KoshAlmaron/A650E_Transmission_Controller/docs/АКПП в разрезе.png

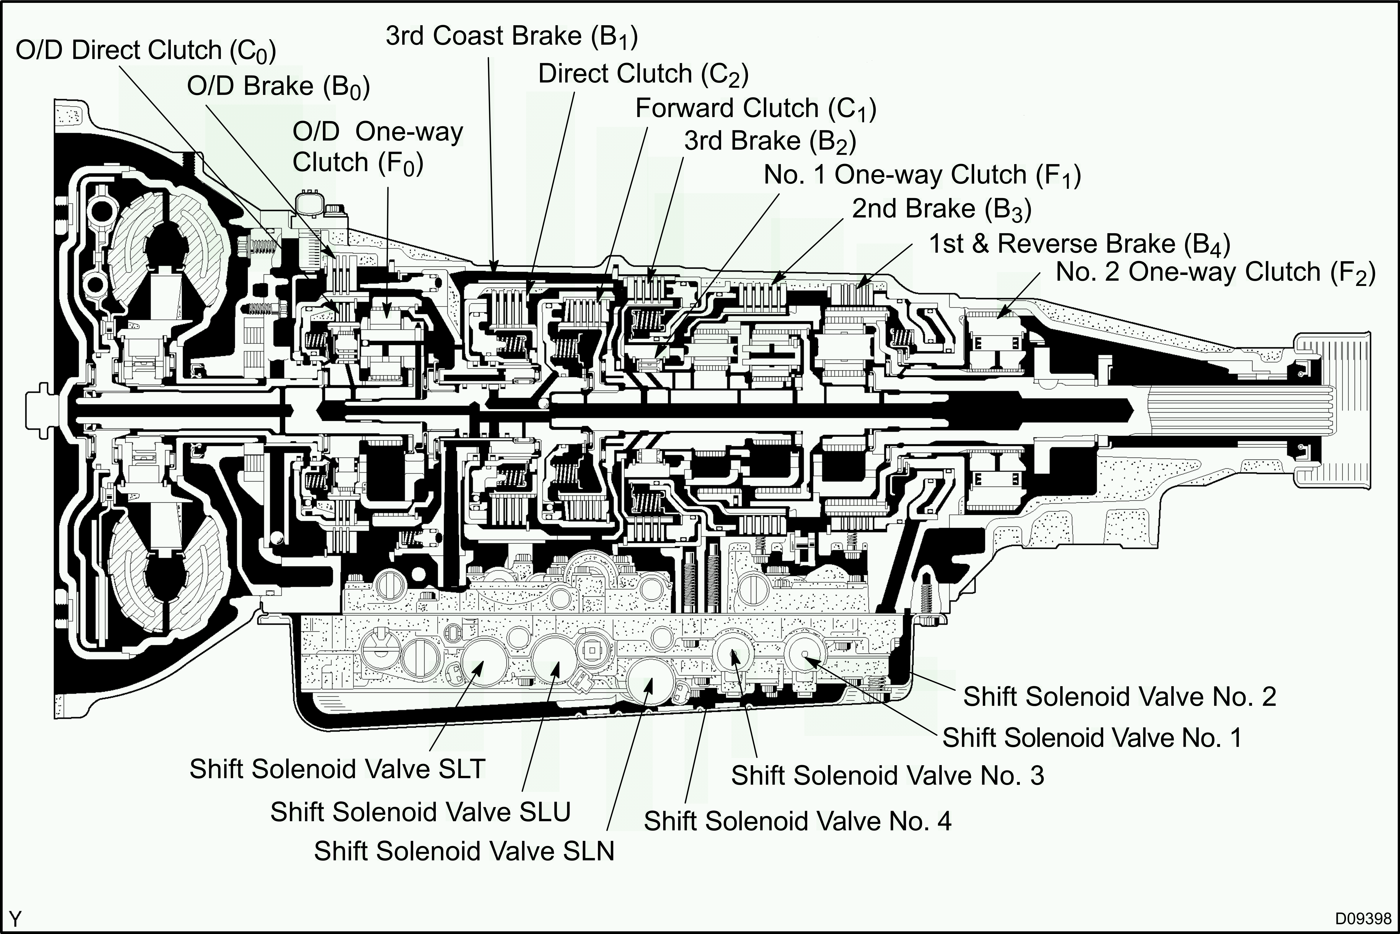
docs/АКПП в разрезе.png
