KoshAlmaron/A650E_Transmission_Controller/docs/Магия второй передачи №1.jpg

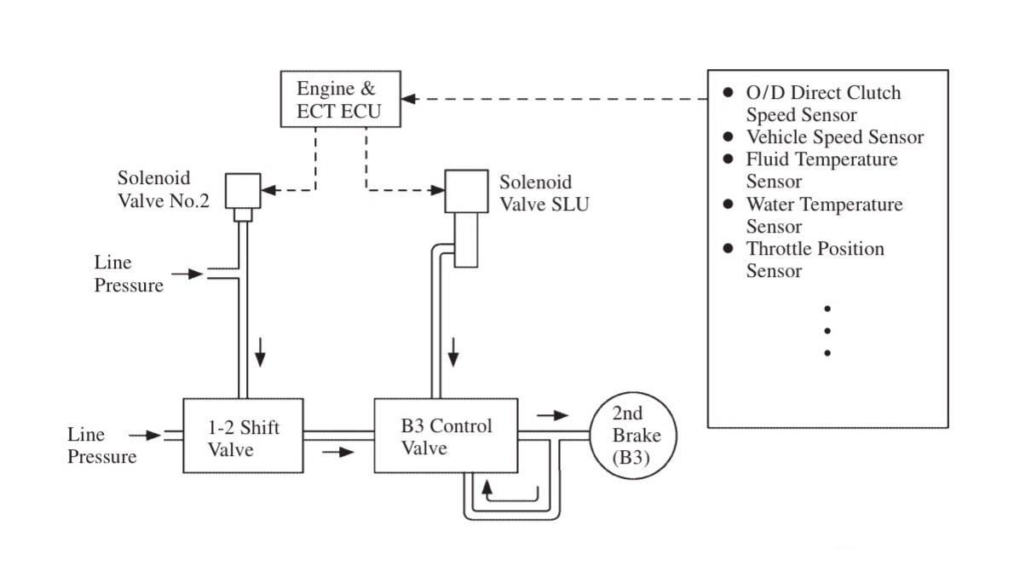
docs/Магия второй передачи №1.jpg
