KoshAlmaron/A650E_Transmission_Controller/docs/Преобразователь сигнала индуктивного датчика.png

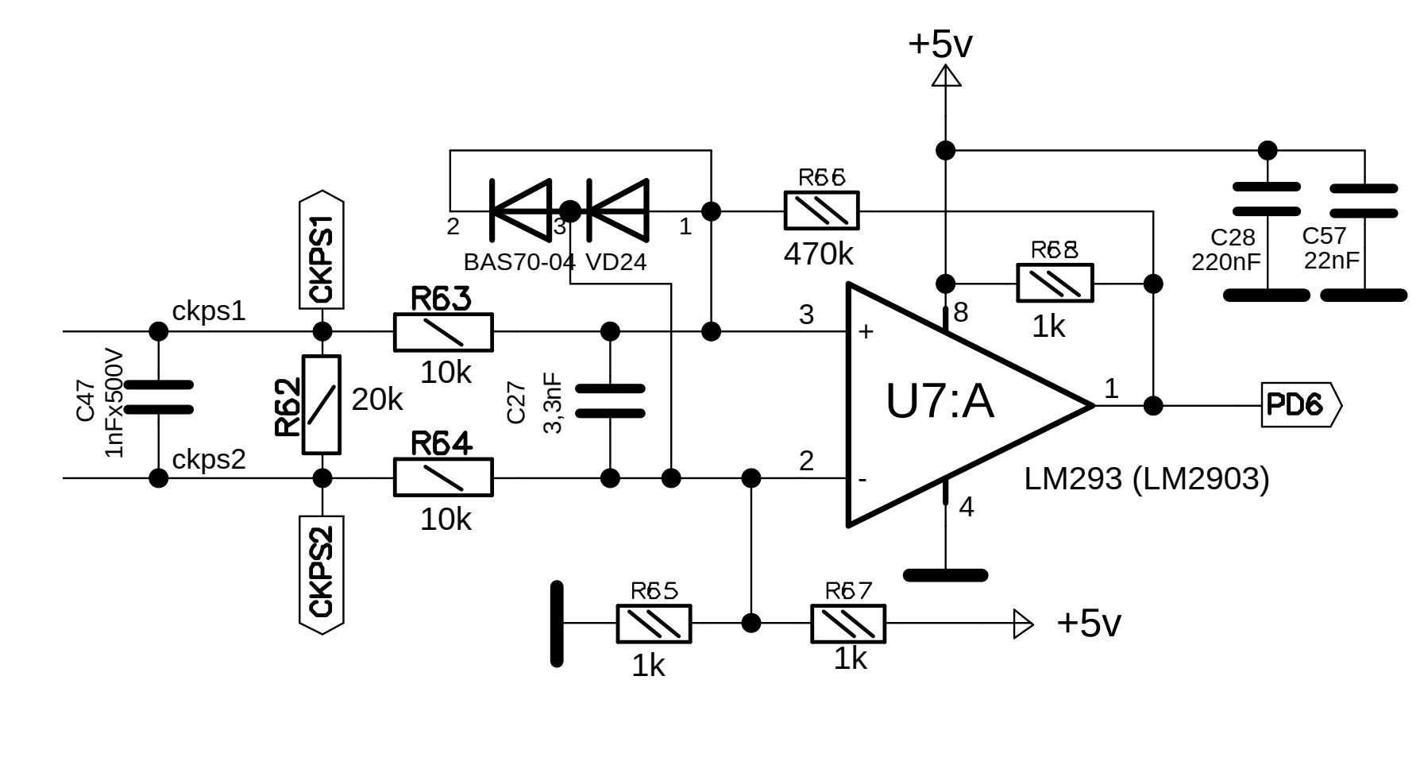
docs/Преобразователь сигнала индуктивного датчика.png
