KoshAlmaron/A650E_Transmission_Controller/docs/Таблица включения соленойдов v2.png

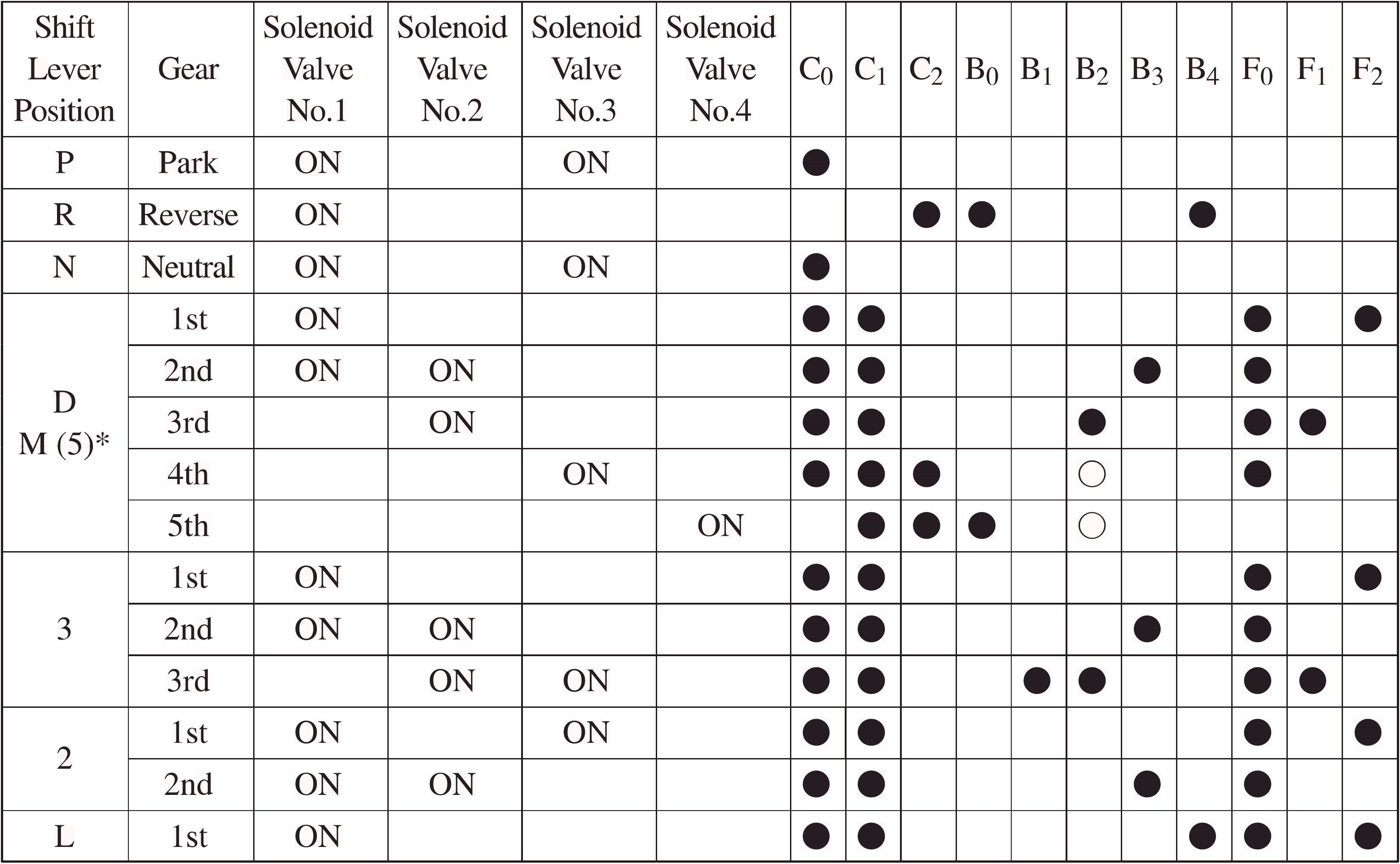
docs/Таблица включения соленойдов v2.png
