KoshAlmaron/A650E_Transmission_Controller/CHANGELOG.md

2024-02-27 - Старт проекта.
2024-03-02 - Написал код для датчиков скорости и температуры.
				Откалибровал датчик температуры.
2024-04-24 - Переход с Ардуино-костыля "Wiring" на номальный AVR C.
2024-05-27 - Написана общая логика работы ЭБУ.
2024-06-13 - Написан весь необходимый функционал для работы АКПП.
2024-06-14 - Добавил функцию обнаружения проскальзывания.
2024-06-20 - Исправил ошибку положения селектора.
				Включил аппаратный фильтр входного сигнала для датчиков оборотов.
2024-07-02 - Добавил управление лампой заднего хода.
2024-07-25 - Добавил управление соленоидами торможения двигателем
				при переключении режимов на ходу.
2024-08-15 - Добавил замедление уменьшения значения ДПДЗ.
				Добавил управление блокировкой гидротрансформатора.
2024-08-20 - Добавил график времени переключения от ДПДЗ.
2024-08-23 - Изменил алгоритм расчета и фильтрации значений датчиков оборотов.
2024-08-31 - Много исправлений алгоритмов переключения передач после первого теста на АКПП.
2024-09-01 - Добавил два отдельных графика от ДПДЗ: 
					время на переключение передачи и задержка после переключения.
				Переделал алгоритм переключений 1>2, 2>3, 3>2.
2024-09-02 - Добавил два графика для включения второй передачи:
				Начальное давление тормоза B3 от ДПДЗ и коррекция от температуры масла.
2024-09-04 - Переписал алгоритм переключений 1>2, 2>3, 3>2.
				Добавил возможность настраивать и сохранять в EEPROM параметры с
				помощью блока отладки.
2024-09-05 - Настроил график давления SLU для включения второй передачи.
2024-09-06 - Добавил экран настройки температурной коррекции SLU для B3.
				Уменьшил шаг сетки графиков по ДПДЗ и температуре масла с 10 до 5.
				Добавил график давления SLT для включения третьей передачи.
2024-09-07 - Еще раз переделал алгоритм переключения передач.
2024-09-08 - Добавил включение соленоида S3 при переключениях 1>2, 2>3, 3>2.
				Сделал плавное включение и выключение блокировки гидротрансформатора.
2024-09-10 - Исправил температурную коррекцию давления, добавка должна быть в процентах.
2024-09-13 - Добавил торможение двинателем на второй передаче в режимах "2" и "3".
				Добавил переключения по оборотам при дросселе более указанного значения.
2024-09-15 - Исправил работу соленоида S3 в режиме "3", исправил включение второй передачи
				после ХХ.
2024-09-26 - Уменьшил тайминги переключения передач.
2024-09-30 - Добавил график давления SLN и график дельты оборотов для включения
				второй передачи после ХХ.
2024-10-08 - Изменил алгоритм управления второй передачей.
2024-10-28 - Управление включением второй передачи происходит не по давлению SLU/SLT,
				а по задержке выключения давления SLU.
2024-10-29 - Исправил зависание заднего хода при резком переключении N->R->D.
2024-11-26 - Добавил дельту оборотов включения второй передачи после ХХ в настройки.
				Улучшил функцию блокировки гидротрансформатора.
2024-11-30 - Исправил ошибку в новой функции блокировки гидротрансформатора.
2024-12-13 - Изменил алгоритм управления SLN.
				Сделал вывод параметров EEPROM в UART при сохранении.
2024-12-14 - Исправил ошибку в работе функции slu_gear2_control.
2025-01-06 - Изменил алгоритм переключения 1>2, 2>3.
				Добавил ограничение включения 5-ой передачи при температуре < 30.
2025-01-11 - Откатил назад алгоритм переключения 1>2.
				Изменил переключение 2>3.
2025-01-13 - Применил температурную коррекцию к значению накачки SLU.
2025-01-20 - Изменил условия срабатывания накачки давления SLU.
2025-02-06 - Изменил расчет прироста SLU при включении второй передачи.
2025-02-12 - Немного изменил работу накачки давления SLU.
2025-04-11 - Добавил функцию запроса снижения мощности вместе
				с контролем включения передачи по оборотам валов.
2025-04-14 - Изменил алгоритм включения второй передачи.
2025-04-07 - Изменил алгоритмы переключений 1>2, 2>3.
2025-04-18 - Добавил функцию автокоррекции давления SLU включения второй передачи.
2025-04-21 - Добавил включение первой передачи через четвертую (N>D), а также
				включение четвертой передачи стоя на месте в режиме D.
2025-04-22 - Изменил алгоритм реакцивации второй передачи.
2025-04-24 - Изменил алгоритм переключения 2>3.
2025-05-03 - Убрал включение четвертой (третьей) вместо первой (2025-04-21), 
				так как это добавляет больше проблем, чем пользы.
2025-05-05 - Изменил алгоритм переключения 2>3.
2025-05-14 - Изменил алгоритм работы блокировки ГТ.
2025-05-16 - Навёл порядок в коде блока отладки.
2025-05-20 - Перешёл на 10-ти битный ШИМ для соленоидов.
2025-05-21 - Исправил работу второй передачи в режимах "3" и "2".
2025-05-27 - Изменил работу блокировки ГТ при переключении передач.
2025-06-10 - Добавил коррекцию по температуре включения SLN при переключении 2>3.
2025-07-21 - Исправил алгоритм реактивации второй передачи.
				Увеличил точность вычисления температурной коррекции.
2025-07-22 - Исправил свежедобавленный баг в функции интерполяции.
2025-07-28 - Мелкие исправления в работе второй передачи.
2025-07-29 - Добавил возможность выбора пинов селектора.
2025-08-06 - Добавил возможность инверсии ШИМ соленоидов в настройках.
2025-08-07 - Добавил возможность инверсии входов в настройках.
				Вернул назад выход на спидометр.
2025-09-05 - Добавил протокол обмена по UART: приём/передача таблиц, запись в EEPROM.
2025-09-08 - Добавил опцию определения работы двигателя по сигналу тахометра.
				Небольшие исправления в протоколе обмена и в алгоритме второй передачи.
2025-09-11 - Добавил в протокол обмена команду чтения из EEPROM.
				Добавил второй порог определения работы двигателя по сигналу тахометра.
2025-09-12 - Добавил второй выход на спидометр и команду тестирования спидометра.
				Добавил в протокол обмена команду установки ограничения передач.
2025-09-16 - Добавил в протокол обмена команду сброса таблиц на значения из прошивки.
				Добавил в пакет данных обороты двигателя.
2025-09-18 - Добавил задержку сброса флага работы двигателя.
2025-10-01 - Исправил ошибку применения адаптации по температуре для второй передачи.
2025-10-02 - Мелкие исправления в работе второй передачи.
2025-10-07 - Добавил в протокол обмена команды применения адаптации второй передачи.
				Добавил график коррекции времени удержания SLU G3 от температуры.
2025-10-09 - Добавил авто адаптацию времени удержания SLU при включении третьей передачи.
2025-10-13 - Изменил алгоритм включения второй передачи.
				Добавил авто адаптацию повторного включения второй передачи.
2025-10-27 - Изменил алгоритм включения режимов RND.
2025-10-31 - Перенес графики АЦП в EEPROM.
2025-11-01 - Изменил диапазон таблиц с процентами: SLTTempCorrGraph, SLUGear2TempCorrGraph,
				SLUGear2TempAdaptGraph. Теперь 100% это 1024, было 100.
				Сделал применение адаптации к двум ячейкам, между которыми находится рабочая точка,
				адаптация между точками распределяется на основе близости к рабочей точке.
2025-11-10 - Исправил ошибку в работе алгоритма адаптации повторного включения второй передачи.
2025-11-15 - Исправил ошибку в выводе ШИМ сигнала для спидометра.
2025-11-21 - Перенес все настройки в EEPROM.
2025-11-27 - Добавил две таблицы: Температурная коррекция опережения по оборотам реактивации
				второй передачи и Адаптация коррекции опережения по оборотам реактивации второй передачи.
				При выключении питания сохраняются в EEPROM только таблицы адаптации.
				Обновил протокол обмена.
				Исправление мелких ошибок в коде.
2025-11-30 - Исправил ошибки предыдущего обновления.
2025-12-01 - Новый алгоритм распределения адаптации между соседними ячейками.
2025-12-08 - Добавил таблицу температурной коррекции для SLN.
2025-12-09 - Перенес все таблицы в структуры.
				Добавил флаги срабатывания адаптаций в основной пакет.
2025-12-14 - Добавил контрольную сумму в протоколе обмена.
				Исправил ошибку при записи EEPROM.
2025-12-16 - Добавил автоматическое переключение между UART0 и UART1.
2025-12-30 - Добавил ручное управление АКПП (Типтроник).
2026-01-09 - Добавил барокоррецию. Исправил ошибки в работе типтроника.
2026-01-20 - Добавил новые функции кнопок ручного управления АКПП (Типтроник).
2026-01-26 - Убрал проверку оборотов для переключения при смене режима АКПП селектором.
2026-02-11 - Добавил команду отправки версии прошивки.
2026-02-12 - Добавил одометер. Изменил формулу расчета скорости.
2026-03-20 - Исправил алгоритм ручного управления АКПП.
2026-03-27 - Добавил в настройках коэффициент перевода оборотов в метры.
2026-04-27 - Отключил адаптацию 1>2 в режиме 2.
				Добавил условие выхода из переключения 2>2 по кикдауну.
				Добавил паузу при понижении передачи для стабилизации давления SLN.
2026-05-19 - Добавил возможность отключения автоматического выхода из ручного режима.
2026-06-05 - При включенной передаче минимальная скорость для вывода на спидометер
				будет всегда больше 0 (2).
2026-06-15 - Изменил логику ожидания при "классических" переключениях.
				Добавил отдельную таблицу давления SLN для пятой передачи.
2026-06-19 - Изменил функцию ожидания включения для классических переключений.
