KoshAlmaron/A650E_Transmission_Controller/docs/Преобразователь сигнала индуктивного датчика.asc

C1: cap; 0.22µ; V=4 Irms=3.56 Rser=0.0381287 Lser=0 mfg="KEMET" pn="C0402C224K7PAC" type="X5R"
C2: cap; 22nf
C3: cap; 3.3nf
C4: cap; 1nf; V=500
D1: schottky; BAS40HM
D2: schottky; BAS40HM
R1: res; 1k
R2: res; 1k
R3: res; 1K; tol=1 pwr=0.1
R4: res; 470k
R5: res; 10k
R6: res; 10k
R7: res; 20k
U1: LTC1441
V1: voltage; SINE(5 25 25)
V2: voltage; 5
Named nets: 0, PD6
.tran 0.25
