KoshAlmaron/A650E_Transmission_Controller/sources/gears.c

#include <stdint.h>			// Коротние название int.
#include <avr/io.h>			// Названия регистров и номера бит.
#include <avr/interrupt.h>	// Прерывания.

#include "gears.h"			// Свой заголовок.
#include "pinout.h"			// Список назначенных выводов.
#include "macros.h"			// Макросы.
#include "mathemat.h"		// Математические функции.
#include "tcudata.h"		// Расчет и хранение всех необходимых параметров.
#include "configuration.h"	// Настройки.
#include "spdsens.h"		// Датчики скорости валов.
#include "buttons.h"		// Кнопки.

extern uint16_t WaitTimer;			// Таймер ожидания из main.
uint16_t GearChangeStep = 100;		// Шаг времени на переключение передачи.

#define GEAR_2_MAX_STEP 20			// Количество шагов при включении второй передачи.
#define GEAR_CHANGE_MAX_TIME 2500	// Максимальное время переключения передачи.

// Максимальная и минимальная передача для каждого режима.
//					I  P   R  N  D  D4 D3 L2 L  E  M
//					0  1   2  3  4  5  6  7  8  9  10
int8_t MaxGear[] = {0, 0, -1, 0, 5, 4, 3, 2, 1, 0, 5};
int8_t MinGear[] = {0, 0, -1, 0, 1, 1, 1, 2, 1, 0, 1};

// Прототипы функций.
void loop_main(uint8_t Wait);		// Прототип функций из main.c.
void glock_control(uint8_t Timer);	// Прототип функций из tculogic.c.

static void gear_change_1_2();
static void gear_change_2_3();
static void gear_change_3_4();
static void gear_change_4_5();

static void gear_change_5_4();
static void gear_change_4_3();
static void gear_change_3_2();
static void gear_change_2_1();

static void gear_up();
static void gear_down();

static void set_gear_change_delays();
static void loop_wait(uint16_t Delay);

static uint8_t rpm_after_ok(uint8_t Shift);

static void gear_change_wait(int8_t GearChange, int8_t Add);

//static void set_slt(uint8_t Value);
static void set_sln(uint16_t Value);
static void set_slu(uint16_t Value);

static void set_solenoids(int8_t Gear);

//============================ Начальные передачи =============================
// Включение нейтрали.
void set_gear_n() {
	TCU.GearChange = -1;
	if (TCU.Gear < 0) {TCU.GearChange = 1;}

	set_slu(CFG.MinPressureSLU);	// Выключение SLU на случай переключения со второй передачи.
	set_sln(get_sln_pressure());
	set_solenoids(0);				// Установка шифтовых соленоидов.

	TCU.Gear = 0;
	TCU.GearChange = 0;
}

// Включение первой передачи.
void set_gear_1() {
	TCU.GearChange = 1;

	set_sln(get_sln_pressure());
	set_solenoids(1);				// Установка шифтовых соленоидов.
	if (TCU.ATMode == 7) {SET_PIN_HIGH(SOLENOID_S3_PIN);}	// Отличие для режима L2. 

	set_slu(get_slu_pressure_gear2());

	TCU.Gear = 1;
	TCU.GearChange = 0;
}

// Включение задней передачи.
void set_gear_r() {
	TCU.GearChange = -1;

	set_slu(CFG.MinPressureSLU);	// Выключение SLU на случай переключения со второй передачи.
	set_sln(get_sln_pressure());
	set_solenoids(-1);				// Установка шифтовых соленоидов.

	TCU.Gear = -1;
	TCU.GearChange = 0;
}

// Блокировка задней передачи.
void disable_gear_r() {
	SET_PIN_HIGH(SOLENOID_S1_PIN);
	SET_PIN_HIGH(SOLENOID_S2_PIN);	// S2 выключает привод.
	SET_PIN_LOW(SOLENOID_S3_PIN);
	SET_PIN_LOW(SOLENOID_S4_PIN);

	set_slu(CFG.MinPressureSLU);
	set_sln(get_sln_pressure());
}

//=========================== Переключения вверх ==============================
static void gear_change_1_2() {
	TCU.GearChange = 1;

	set_solenoids(2);					// Установка шифтовых соленоидов.
	SET_PIN_HIGH(SOLENOID_S3_PIN);		// Включаем систему "Clutch to Clutch".

	uint16_t NextSLU = get_slu_pressure_gear2();
	set_slu(NextSLU);

	TCU.GearChangeTPS = TCU.Load;
	TCU.GearChangeSLU = TCU.SLU;

	set_sln(CFG.MinPressureSLN);

	TCU.GearStep = 0;		// Шаг процесса включения передачи.
	uint8_t PDR = 0;		// Состояние процесса запроса снижения мощности.
	uint8_t PDRStep = 0;	// Для фиксации времени работы PDR.
	TCU.LastStep = GEAR_2_MAX_STEP;	// Номер последнего шага переключения.
	uint8_t SLUDelay = 0;	// Пауза повышения давления после начала переключения.
	int8_t Adaptation = 0;	// Флаг применения адаптации.
	TCU.LastPDRTime = 0;
	if (TCU.Load > CFG.PowerDownMaxTPS) {PDR = -1;}
	
	uint8_t InitLoad = TCU.Load;	// Значение ДПДЗ c бароккорекцией в начале цикла.
	while (TCU.GearStep < GEAR_2_MAX_STEP) {
		set_gear_change_delays();		// Установка длительности 1 шага переключения от ДПДЗ.
		WaitTimer = GearChangeStep;		// Устанавливаем время ожидания.
		while (WaitTimer) {
			loop_main(1);

			// Отключение передачи при сбросе газа.
			if (TCU.InstTPS <= CFG.IdleTPSLimit && TCU.ATMode != 6 && TCU.ATMode != 7) {
				set_solenoids(1);
				set_slu(CFG.MinPressureSLU);
				set_sln(CFG.IdlePressureSLN);
				loop_wait(200);
				TCU.Gear = 2;
				TCU.Gear2State = 0;
				TCU.GearChange = 0;
				return;
			}

			NextSLU = get_slu_pressure_gear2() + TCU.GearStep * 2 - SLUDelay;
			set_slu(NextSLU);

			if (!PDR && rpm_delta(1) < -50) {			// Переключение началось.
				PDR = 1;
				SLUDelay = 3;
				PDRStep = TCU.GearStep;
				SET_PIN_HIGH(REQUEST_POWER_DOWN_PIN);	// Запрашиваем снижение мощности.
			}
		}
		TCU.GearStep++;

		// Обороты валов выровнялись.
		if (ABS(rpm_delta(2)) < 35) {
			if (PDR == 1) {TCU.LastPDRTime = (TCU.GearStep - PDRStep) * GearChangeStep;}
			SET_PIN_LOW(REQUEST_POWER_DOWN_PIN);

			if (TCU.LastStep == GEAR_2_MAX_STEP) {TCU.LastStep = TCU.GearStep;}

			if (TCU.GearStep < 14 && !Adaptation) {
				// Передача включилась слишком рано,
				// снижаем давление на 1 единицу.
				Adaptation = -1;
				save_gear2_slu_adaptation(-1, (InitLoad + TCU.Load) / 2);
			}
		}
		if (TCU.GearStep > 16 && rpm_delta(2) > 35 && !Adaptation) {
			// Передача включилась слишком поздно,
			// повышаем давление на 1 единицу.
			Adaptation = 1;
			save_gear2_slu_adaptation(1, (InitLoad + TCU.Load) / 2);
		}
	}

	SET_PIN_LOW(SOLENOID_S3_PIN);
	set_sln(CFG.IdlePressureSLN);
	SET_PIN_LOW(REQUEST_POWER_DOWN_PIN);
	
	TCU.Gear = 2;
	TCU.Gear2State = 8;
	TCU.GearChange = 0;
}

static void gear_change_2_3() {
	// Не включать третью при недовключенной второй передаче.
	if (TCU.Gear2State != 8 && TCU.InstTPS > CFG.IdleTPSLimit && !TCU.ManualModeTimer) {return;}
	TCU.GearChange = 1;

	// Ручное включение третьей передачи при выключенной второй.
	if (TCU.Gear2State == 0) {
		set_slu(CFG.MinPressureSLU);
		set_sln(get_sln_pressure_gear3());
		loop_wait(GearChangeStep * 5);

		set_solenoids(3);
		loop_wait(GearChangeStep * 2);
		set_sln(CFG.IdlePressureSLN);

		TCU.Gear = 3;
		TCU.GearChange = 0;
		return;
	}

	set_solenoids(3);		// Установка шифтовых соленоидов.

	set_slu(get_slu_pressure_gear3());
	TCU.GearChangeTPS = TCU.Load;
	TCU.GearChangeSLU = TCU.SLU;

	set_sln(CFG.IdlePressureSLN);

	WaitTimer = get_gear3_slu_delay();				// Время удержания давления SLU.
	int16_t SLNOffset = get_gear3_sln_offset();		// Смещение времени включения SLN.
	uint8_t SetSLN = 0;		// Флаг установки давления SLN
	int8_t Adaptation = 0;	// Флаг применения адаптации.

	uint8_t PDR = 0;		// Флаг применения запроса снижения мощности.
	uint16_t PDRTime = 0;	// Длительность применения снижения мощности.

	// Ждем начало включения B2.
	uint8_t InitLoad = TCU.Load;	// Значение ДПДЗ с барокоррекцией в начале цикла.
	while (WaitTimer) {
		loop_main(1);

		// Давление SLU включения третьей передачи
		set_slu(get_slu_pressure_gear3());
		
		if (!SetSLN) {
			SLNOffset = get_gear3_sln_offset();
		 	if (WaitTimer + SLNOffset < 5) {SetSLN = 1;}	// Пересечение SNL и SLU при SLNOffset < 0.
		}
		else {set_sln(get_sln_pressure_gear3());}
	}
	set_slu(CFG.MinPressureSLU);		// Убираем давление SLU.

	if (TCU.Load > CFG.PowerDownMaxTPS) {PDR = -1;}

	WaitTimer = 1500;						// Время ожидания завершения переключения.
	uint16_t GearTestTimer = WaitTimer;		// Таймер для проверки начала переключения.
	// Ждем включения третьей передачи.
	while (WaitTimer && rpm_delta(3) > 35) {
		int16_t Delta2 = rpm_delta(2);

		loop_main(1);

		// Проверка на закусывание передачи 2 и 3.
		// Через 40 мс после сброса давления SLU должно начаться изменение передаточного числа.
		if (GearTestTimer && !Adaptation && GearTestTimer - WaitTimer >= 40) {
			GearTestTimer = 0;
			if (Delta2 > -5) {Adaptation = -1;}	// Произошло закусывание (?).
		}
		
		if (!PDR && Delta2 < -50) {		// Переключение началось.
			PDR = 1;
			PDRTime = WaitTimer;
			SET_PIN_HIGH(REQUEST_POWER_DOWN_PIN);
		}

		if (!SetSLN) {
			SLNOffset = get_gear3_sln_offset();
		 	if (1500 - WaitTimer > SLNOffset) {SetSLN = 1;}		// Задержка SLN при SLNOffset > 0.
		}
		else {set_sln(get_sln_pressure_gear3());}				// Устанавливаем давление SLN.

		if (Adaptation != 1 && Delta2 > 30) {
			// Проскальзывание второй передачи.
			// Выключение SLU произошло слишком рано.
			Adaptation = 1;
		}
	}

	TCU.GearChangeSLN = TCU.SLN;
	set_sln(CFG.IdlePressureSLN);

	SET_PIN_LOW(REQUEST_POWER_DOWN_PIN);
	if (PDR == 1) {TCU.LastPDRTime = PDRTime - WaitTimer;}

	// Включаем торможение двигателем в режиме "3".
	if (TCU.ATMode == 6) {SET_PIN_HIGH(SOLENOID_S3_PIN);}

	// Применение адаптации.
	if (Adaptation) {save_gear3_slu_adaptation(Adaptation, (InitLoad + TCU.Load) / 2);}

	TCU.Gear = 3;
	TCU.Gear2State = 0;
	TCU.GearChange = 0;
}

static void gear_change_3_4() {
	TCU.GearChange = 1;

	set_sln(get_sln_pressure());
	loop_wait(GearChangeStep * 3);
	set_solenoids(4);		// Установка шифтовых соленоидов.

	TCU.GearChangeTPS = TCU.Load;
	TCU.GearChangeSLT = TCU.SLT;
	TCU.GearChangeSLN = TCU.SLN;
	
	gear_change_wait(1, 0);

	TCU.Gear = 4;
	TCU.GearChange = 0;	
}

static void gear_change_4_5() {
	if (TCU.OilTemp < 30) {return;}
	TCU.GearChange = 1;

	set_sln(get_sln_pressure_gear5());
	loop_wait(GearChangeStep * 3);
	set_solenoids(5);		// Установка шифтовых соленоидов.

	gear_change_wait(1, 0);

	TCU.Gear = 5;
	TCU.GearChange = 0;	
}

//=========================== Переключения вниз ===============================
static void gear_change_5_4() {
	TCU.GearChange = -1;

	// Подгазовка.
	//if (TCU.InstTPS <= CFG.IdleTPSLimit) {SET_PIN_HIGH(REQUEST_POWER_DOWN_PIN);}
	
	// Добавка к значению SLN из таблицы.
	int8_t Add = 64;

	if (TCU.Glock) {			// Отключаем блокировку ГТ.
		set_slu(CFG.MinPressureSLU);
		TCU.Glock = 64;			// Сброс счётчика блокировки
	}

	set_sln(get_sln_pressure() + Add);
	loop_wait(GearChangeStep * 3);
	set_solenoids(4);		// Установка шифтовых соленоидов.

	gear_change_wait(-1, Add);

	TCU.Gear = 4;
	TCU.GearChange = 0;		
}

static void gear_change_4_3() {
	TCU.GearChange = -1;

	// Добавка к значению SLN из таблицы.
	int8_t Add = 32;

	if (TCU.Glock) {			// Отключаем блокировку ГТ.
		set_slu(CFG.MinPressureSLU);
		TCU.Glock = 64;			// Сброс счётчика блокировки
	}
	set_sln(get_sln_pressure() + Add);
	loop_wait(GearChangeStep * 3);
	
	set_solenoids(3);			// Установка шифтовых соленоидов.
	// Отличие для режима 3. 
	if (TCU.ATMode == 6) {SET_PIN_HIGH(SOLENOID_S3_PIN);}

	gear_change_wait(-1, Add);

	TCU.Gear = 3;
	TCU.GearChange = 0;	
}

static void gear_change_3_2() {
	TCU.GearChange = -1;

	if (TCU.ATMode == 6 || TCU.ATMode == 7) {
		// Включение второй передачи в режимах "3" и "L2".
		set_solenoids(2);					// Установка шифтовых соленоидов.
		SET_PIN_HIGH(SOLENOID_S3_PIN);		// Включаем систему "Clutch to Clutch".

		uint16_t NextSLU = get_slu_pressure_gear2();
		set_slu(NextSLU);
		set_sln(CFG.MinPressureSLN);

		TCU.GearStep = 0;		// Шаг процесса включения передачи.

		while (TCU.GearStep < GEAR_2_MAX_STEP) {
			set_gear_change_delays();		// Длительность 1 шага переключения от ДПДЗ.
			WaitTimer = GearChangeStep;		// Устанавливаем время ожидания.
			while (WaitTimer) {
				loop_main(1);

				NextSLU = get_slu_pressure_gear2() + TCU.GearStep * 2;
				set_slu(NextSLU);
			}
			TCU.GearStep++;
		}
		SET_PIN_LOW(SOLENOID_S3_PIN);
		set_sln(CFG.IdlePressureSLN);
		TCU.Gear2State = 8;
	}
	else {
		// Без торможения двигателем вторая передача будет включаться
		// в функции slu_gear2_control.
		set_solenoids(1);					// Установка шифтовых соленоидов.
		set_slu(CFG.MinPressureSLU);
		loop_wait(100);
		TCU.Gear2State = 0;
	}

	TCU.Gear = 2;
	TCU.GearChange = 0;	
}	

static void gear_change_2_1() {
	TCU.GearChange = -1;

	set_solenoids(1);		// Установка шифтовых соленоидов.
	// Отличие для режима L2. 
	if (TCU.ATMode == 7) {SET_PIN_HIGH(SOLENOID_S3_PIN);}

	set_slu(CFG.MinPressureSLU);
	set_sln(get_sln_pressure());
	loop_wait(GearChangeStep * 8);
	set_sln(CFG.IdlePressureSLN);

	TCU.Gear = 1;
	TCU.Gear2State = 0;
	TCU.GearChange = 0;
}

//========================== Вспомогательные функции ==========================

// Контроль переключения передач.
void gear_control() {
	if (TCU.ManualModeTimer && CFG.TiptronicTimer) {TCU.ManualModeTimer--;}

	// Только режимы D - L.
	if (TCU.ATMode < 4 || TCU.ATMode > 8) {return;}
	if (TCU.Gear < 1 || TCU.Gear > 5) {return;}

	set_gear_change_delays();	// Длительность 1 шага переключения от ДПДЗ.
	TCU.GearUpSpeed = get_gear_max_speed(TCU.Gear);		// Верхняя граница переключения.
	TCU.GearDownSpeed = get_gear_min_speed(TCU.Gear);	// Нижняя граница переключения.

	// Переключения при изменение режима АКПП без проверки оборотов.
	if (TCU.Gear > MaxGear[TCU.ATMode]) {
		gear_down();
		return;
	}
	if (TCU.Gear < MinGear[TCU.ATMode]) {
		gear_up();
		return;
	}

	// Ручное управление.
	if (CFG.TiptronicEnable) {
		// При коротком нажатии сбрасывается таймер ожидания.
		if (is_button_press_short(TIP_GEAR_UP)) {	// Короткое нажатие вверх.
			TCU.ManualModeTimer = CFG.TiptronicTimer + 1;
			if (TCU.Gear < MaxGear[TCU.ATMode]) {gear_up();}
			return;
		}
		if (is_button_press_short(TIP_GEAR_DOWN)) {	// Короткое нажатие вниз.
			TCU.ManualModeTimer = CFG.TiptronicTimer + 1;
			if (TCU.Gear > MinGear[TCU.ATMode] && rpm_after_ok(-1)) {gear_down();}
			return;
		}

		if (is_button_press_long(TIP_GEAR_UP)) {	// Длинное нажатие вверх - сброс таймера.
			TCU.ManualModeTimer = 0;
			return;
		}
		// При удержании кнопки вверх сбросится таймер,
		// и будет удержание текущей передачи до отпускания кнопки.
		if (is_button_hold_down(TIP_GEAR_UP)) {return;}

		if (is_button_press_long(TIP_GEAR_DOWN)) {	// Длинное нажатие вниз - переключение вниз.
			if (TCU.Gear > MinGear[TCU.ATMode] && rpm_after_ok(-1)) {gear_down();}
			return;
		}
		// При удержании кнопки вниз произойдёт переключение вниз,
		// и удержание передачи до отпускания кнопки.
		if (is_button_hold_down(TIP_GEAR_DOWN)) {return;}

		if (TCU.ManualModeTimer) {return;}
	}
	else {
		TCU.ManualModeTimer = 0;	// Сброс таймера в других режимах.
	}

	// Скорость выше порога.
	if (TCU.CarSpeed > TCU.GearUpSpeed) {
		if (TCU.InstTPS > CFG.IdleTPSLimit) {	// Не повышать передачу при сбросе газа.
			if (rpm_after_ok(1)) {gear_up();}
		}
		return;
	}
	// Скорость ниже порога.
	if (TCU.CarSpeed < TCU.GearDownSpeed) {
		if (rpm_after_ok(-1)) {gear_down();}
		return;
	}
}

void slu_gear2_control() {
	// Дельта оборотов, при котором началось переключение.
	static int16_t InitDrumRPMDelta = 0;
	// 0 - ХХ,
	// 1 - плавное включение,
	// 8 - рабочий режим.

	if (TCU.Gear == 1) {set_slu(get_slu_pressure_gear2());}

	if (TCU.Gear != 2) {
		TCU.GearStep = 0;
		TCU.Gear2State = 0;
		return;
	}

	// Отключение передачи при сбросе газа.
	if (TCU.InstTPS <= CFG.IdleTPSLimit && TCU.ATMode != 6 && TCU.ATMode != 7) {
		if (TCU.Gear2State > 0) {
			set_solenoids(1);
			set_slu(CFG.MinPressureSLU);
			loop_wait(200);
		}
		TCU.Gear2State = 0;
	}

	int16_t DeltaRPM = rpm_delta(2);
	int16_t MaxDeltaRPM = 0;
	uint16_t NextSLU = get_slu_pressure_gear2();		// Начальное давление.
	uint16_t WorkSLU = NextSLU + ((NextSLU * 32) >> 7);	// Рабочее давление (+25%).

	switch (TCU.Gear2State) {
		case 0:
			// При временном отключении второй передачи, давление SLU не сбрасывается,
			// Вместо этого включается первая передача.
			set_solenoids(1);
			TCU.GearStep = 0;
			set_slu(WorkSLU);
			InitDrumRPMDelta = 0;

			if (TCU.ATMode == 6 || TCU.ATMode == 7) {	// Переключили режим АКПП.
				set_slu(NextSLU);
				loop_wait(200);
				set_solenoids(2);
				SET_PIN_HIGH(SOLENOID_S3_PIN);		// Включаем систему "Clutch to Clutch".
				TCU.Gear2State = 1;
			}
			else if (TCU.InstTPS > CFG.IdleTPSLimit && (-1 * DeltaRPM) < get_gear2_rpm_adv()) {
				InitDrumRPMDelta = TCU.DrumRPMDelta;
				set_slu(NextSLU);
				loop_wait(200);
				set_solenoids(2);
				SET_PIN_HIGH(SOLENOID_S3_PIN);		// Включаем систему "Clutch to Clutch".
				TCU.Gear2State = 1;
			}
			break;
		case 1:
			// Плавное включение второй передачи.
			set_solenoids(2);					// Установка шифтовых соленоидов.
			SET_PIN_HIGH(SOLENOID_S3_PIN);		// Включаем систему "Clutch to Clutch".
			TCU.GearStep = 0;
			while (TCU.GearStep < GEAR_2_MAX_STEP) {
				set_gear_change_delays();		// Длительность 1 шага переключения от ДПДЗ.
				// Устанавливаем время ожидания.
				if (TCU.ATMode == 6 || TCU.ATMode == 7) {WaitTimer = GearChangeStep;}
				else {WaitTimer = CFG.G2ReactStepSize;}	// Статическое значение при реактивации.

				while (WaitTimer) {
					loop_main(1);
					DeltaRPM = rpm_delta(2);
					TCU.GearDownSpeed = get_gear_min_speed(TCU.Gear);

					// Отключение передачи при сбросе газа.
					if (TCU.InstTPS <= CFG.IdleTPSLimit && TCU.ATMode != 6 && TCU.ATMode != 7) {
						set_solenoids(1);
						set_slu(CFG.MinPressureSLU);
						loop_wait(200);
						TCU.Gear2State = 0;
						return;
					}

					// Скорость ниже порога.
					if (TCU.CarSpeed < TCU.GearDownSpeed) {
						TCU.Gear2State = 0;
						gear_change_2_1();
						return;
					}

					// Фиксация максимальной разница оборотов (проскальзывание).
					if (DeltaRPM > MaxDeltaRPM) {MaxDeltaRPM = DeltaRPM;}

					NextSLU = get_slu_pressure_gear2() + TCU.GearStep * 2;
					set_slu(NextSLU);
				}
				TCU.GearStep++;
			}
			SET_PIN_LOW(SOLENOID_S3_PIN);
			set_sln(CFG.IdlePressureSLN);
			TCU.Gear2State = 8;

			// Применение адаптации.
			if (TCU.ATMode != 6 && TCU.ATMode != 7 && InitDrumRPMDelta) {
				// Обороты проскачили нулевую точку, передача включилась поздно.
				if (MaxDeltaRPM > 60) {save_gear2_adv_adaptation(1, InitDrumRPMDelta);}
				// Обороты сликом близко к нулевойю точку, передача включилась рано.
				else if (MaxDeltaRPM < 40) {save_gear2_adv_adaptation(-1, InitDrumRPMDelta);}
			}
			break;
		case 8:
			set_slu(WorkSLU);
			break;
	}
}

// Настройка выходов шифтовых селеноидов, а также лампы заднего хода.
void solenoid_init() {
	SET_PIN_MODE_OUTPUT(SOLENOID_S1_PIN);
	SET_PIN_LOW(SOLENOID_S1_PIN);
	SET_PIN_MODE_OUTPUT(SOLENOID_S2_PIN);
	SET_PIN_LOW(SOLENOID_S2_PIN);
	SET_PIN_MODE_OUTPUT(SOLENOID_S3_PIN);
	SET_PIN_LOW(SOLENOID_S3_PIN);
	SET_PIN_MODE_OUTPUT(SOLENOID_S4_PIN);
	SET_PIN_LOW(SOLENOID_S4_PIN);

	SET_PIN_MODE_OUTPUT(REAR_LAMP_PIN);
	SET_PIN_LOW(REAR_LAMP_PIN);

	// Запрос снижения мощности.
	SET_PIN_MODE_OUTPUT(REQUEST_POWER_DOWN_PIN);
	SET_PIN_LOW(REQUEST_POWER_DOWN_PIN);	
}

static void gear_change_wait(int8_t GearChange, int8_t Add) {
	uint8_t PDR = 0;
	uint16_t PDRTime = 0;	// Для фиксации времени работы PDR.
	if (TCU.Load > CFG.PowerDownMaxTPS) {PDR = -1;}
	TCU.LastPDRTime = 0;
	WaitTimer = GEAR_CHANGE_MAX_TIME;		// Устанавливаем время ожидания.

	// Отличие оборотов от текущей передачи.
	int16_t DeltaCurr = rpm_delta(TCU.Gear) * GearChange;	
	// Отличие оборотов от следующей передачи.
	int16_t DeltaNext = rpm_delta(TCU.Gear + GearChange) * GearChange;

	while (WaitTimer && DeltaNext > 35) {
		DeltaCurr = rpm_delta(TCU.Gear) * GearChange;	
		DeltaNext = rpm_delta(TCU.Gear + GearChange) * GearChange;

		if (TCU.Gear == 4 && GearChange == 1) {set_sln(get_sln_pressure_gear5());}
		else {set_sln(get_sln_pressure() + Add);}
		if (DeltaCurr < -70) {						// Переключение началось.
			if (TCU.Glock && GearChange == 1) {		// Отключаем блокировку ГТ.
				set_slu(CFG.MinPressureSLU);
				TCU.Glock = 64;				// Сброс счётчика блокировки
			}
			if (!PDR) {						// Запрашиваем снижение мощности.
				PDR = 1;
				PDRTime = WaitTimer;
				SET_PIN_HIGH(REQUEST_POWER_DOWN_PIN);
			}
		}
		loop_main(1);
	}

	SET_PIN_LOW(REQUEST_POWER_DOWN_PIN);
	if (PDR == 1) {TCU.LastPDRTime = PDRTime - WaitTimer;}
	loop_wait(GearChangeStep * 3);
	set_sln(CFG.IdlePressureSLN);
}

// Обновление порогов переключения передач.
void update_gear_speed() {
	TCU.GearUpSpeed = get_gear_max_speed(TCU.Gear);		// Верхняя граница переключения.
	TCU.GearDownSpeed = get_gear_min_speed(TCU.Gear);	// Нижняя граница переключения.
}

// Переключение вверх.
static void gear_up() {
	if (TCU.Gear >= MaxGear[TCU.ATMode]) {return;}

	switch (TCU.Gear) {
		case 1:
			gear_change_1_2();
			break;
		case 2:
			gear_change_2_3();
			break;
		case 3:
			gear_change_3_4();
			break;
		case 4:
			gear_change_4_5();
			break;
	}
}

// Переключение вниз.
static void gear_down() {
	if (TCU.Gear <= MinGear[TCU.ATMode]) {return;}

	switch (TCU.Gear) {
		case 2:
			gear_change_2_1();
			break;
		case 3:
			gear_change_3_2();
			break;
		case 4:
			gear_change_4_3();
			break;
		case 5:
			gear_change_5_4();
			break;
	}	
}

static void set_gear_change_delays() {
	GearChangeStep = get_interpolated_value_uint16_t(TCU.Load, GRIDS.TPSGrid, TABLES.GearChangeStepArray, TPS_GRID_SIZE);
}

// Ожидание с основным циклом.
static void loop_wait(uint16_t Delay) {
	WaitTimer = Delay;		// Устанавливаем время ожидания.
	while (WaitTimer) {loop_main(1);}
}

uint8_t get_gear_max_speed(int8_t Gear) {
	if (Gear == 5 || Gear <= 0) {return 130;}

	uint8_t* Array;
	switch (Gear) {
		case 1:
			Array = SPEED.Gear_1_2;
			break;
		case 2:
			Array = SPEED.Gear_2_3;
			break;
		case 3:
			Array = SPEED.Gear_3_4;
			break;
		case 4:
			Array = SPEED.Gear_4_5;
			break;
		default:
			return 0;
	}

	uint16_t Speed = get_interpolated_value_uint8_t(TCU.TPS, GRIDS.TPSGrid, Array, TPS_GRID_SIZE);
	return Speed;
}

uint8_t get_gear_min_speed(int8_t Gear) {
	if (Gear <= 1) {return 5;}

	uint8_t* Array;
	switch (Gear) {
		case 2:
			Array = SPEED.Gear_2_1;
			break;
		case 3:
			Array = SPEED.Gear_3_2;
			break;
		case 4:
			Array = SPEED.Gear_4_3;
			break;
		case 5:
			Array = SPEED.Gear_5_4;
			break;
		default:
			return 0;
	}

	uint16_t Speed = get_interpolated_value_uint8_t(TCU.TPS, GRIDS.TPSGrid, Array, TPS_GRID_SIZE);
	return Speed;
}

static uint8_t rpm_after_ok(uint8_t Shift) {
	// Разрешить переключение стоя на тормозе на ХХ.
	if (!TCU.OutputRPM && TCU.InstTPS <= CFG.IdleTPSLimit && TCU.Break) {return 1;}

	uint8_t Gear = TCU.Gear + Shift;
	uint16_t NewRPM = 0;
	switch (Gear) {
		case 1:
			NewRPM = ((uint32_t) TCU.OutputRPM * GEAR_1_RATIO) >> 10;
			break;
		case 2:
			NewRPM = ((uint32_t) TCU.OutputRPM * GEAR_2_RATIO) >> 10;
			break;
		case 3:
			NewRPM = ((uint32_t) TCU.OutputRPM * GEAR_3_RATIO) >> 10;
			break;
		case 4:
			NewRPM = ((uint32_t) TCU.OutputRPM * GEAR_4_RATIO) >> 10;
			break;
		case 5:
			NewRPM = ((uint32_t) TCU.OutputRPM * GEAR_5_RATIO) >> 10;
			break;
	}

	if (NewRPM > CFG.AfterChangeMinRPM && NewRPM < CFG.AfterChangeMaxRPM) {return 1;}
	else {return 0;}
}

static void set_sln(uint16_t Value) {
	TCU.SLN = Value;
	cli();
		OCR1B = TCU.SLN;	// SLN - выход B таймера 1.
	sei();
}

static void set_slu(uint16_t Value) {
	TCU.SLU = Value;
	cli();
		OCR1C = TCU.SLU;	// SLU - выход C таймера 1.
	sei();
}

int8_t get_min_gear(uint8_t Mode) {
	return MinGear[Mode];
}

int8_t get_max_gear(uint8_t Mode) {
	return MaxGear[Mode];
}

void set_gear_limit(uint8_t Min, uint8_t Max) {
	#ifdef SELECTOR_HAS_D4_MODE
		MinGear[5] = Min;
		MaxGear[5] = Max;
	#else
		MinGear[4] = Min;
		MaxGear[4] = Max;
	#endif
}

static void set_solenoids(int8_t Gear) {
	switch (Gear) {
		case -1:
			SET_PIN_HIGH(SOLENOID_S1_PIN);
			SET_PIN_LOW(SOLENOID_S2_PIN);
			SET_PIN_LOW(SOLENOID_S3_PIN);
			SET_PIN_LOW(SOLENOID_S4_PIN);
			break;
		case 0:
			SET_PIN_HIGH(SOLENOID_S1_PIN);
			SET_PIN_LOW(SOLENOID_S2_PIN);
			SET_PIN_HIGH(SOLENOID_S3_PIN);
			SET_PIN_LOW(SOLENOID_S4_PIN);
			break;
		case 1:
			SET_PIN_HIGH(SOLENOID_S1_PIN);
			SET_PIN_LOW(SOLENOID_S2_PIN);
			SET_PIN_LOW(SOLENOID_S3_PIN);
			SET_PIN_LOW(SOLENOID_S4_PIN);
			break;
		case 2:
			SET_PIN_HIGH(SOLENOID_S1_PIN);
			SET_PIN_HIGH(SOLENOID_S2_PIN);
			SET_PIN_LOW(SOLENOID_S3_PIN);
			SET_PIN_LOW(SOLENOID_S4_PIN);
			break;
		case 3:
			SET_PIN_LOW(SOLENOID_S1_PIN);
			SET_PIN_HIGH(SOLENOID_S2_PIN);
			SET_PIN_LOW(SOLENOID_S3_PIN);
			SET_PIN_LOW(SOLENOID_S4_PIN);
			break;
		case 4:
			SET_PIN_LOW(SOLENOID_S1_PIN);
			SET_PIN_LOW(SOLENOID_S2_PIN);
			SET_PIN_HIGH(SOLENOID_S3_PIN);
			SET_PIN_LOW(SOLENOID_S4_PIN);
			break;
		case 5:
			SET_PIN_LOW(SOLENOID_S1_PIN);
			SET_PIN_LOW(SOLENOID_S2_PIN);
			SET_PIN_LOW(SOLENOID_S3_PIN);
			SET_PIN_HIGH(SOLENOID_S4_PIN);
			break;
	}
}
