KoshAlmaron/A650E_Transmission_Controller/sources/tcudata_tables.h

// Значения от датчиков и значения для ШИМ задаются в "сыром" виде,
// 0-1023 и 0-255 соответственно.

#ifndef _TCUDATA_TABLES_H_
	#define _TCUDATA_TABLES_H_

	//================================ Сетки осей =============================
	GRIDS_t GRIDS = {
		.TPSGrid = {0, 5, 10, 15, 20, 25, 30, 35, 40, 45, 50, 55, 60, 65, 70, 75, 80, 85, 90, 95, 100},
		.TempGrid = {-30, -25, -20, -15, -10, -5, 0, 5, 10, 15, 20, 25, 30, 35, 40, 45, 50, 55, 60, 65, 70, 75, 80, 85, 90, 95, 100, 105, 110, 115, 120},
		.DeltaRPMGrid = {0, 20, 40, 60, 80, 100, 120, 140, 160, 180, 200, 220, 240, 260, 280, 300, 320, 340, 360, 380, 400}
	};

	//=================================== Датчики =============================
	ADCTBL_t ADCTBL = {
		.TPSGraph = {97, 135, 173, 211, 249, 288, 326, 364, 402, 440, 478, 516, 554, 592, 630, 669, 707, 745, 783, 821, 859},
		.OilTempGraph = {1005, 999, 992, 982, 972, 953, 934, 904, 873, 834, 795, 753, 711, 667, 623, 580, 536, 494, 452, 414, 376, 344, 311, 284, 256, 233, 210, 191, 172, 156, 140}
	};

	//================================== Адаптация ============================
	ADAPT_t ADAPT = {
		.SLUGear2TPSAdaptGraph = {0},
		.SLUGear2TempAdaptGraph = {0},

		.Gear2AdvAdaptGraph = {0},
		.Gear2AdvTempAdaptGraph = {0},

		.SLUGear3TPSAdaptGraph = {0},
		.SLUGear3TempAdaptGraph = {0}
	};

	//============================== Основные таблицы =========================
	TABLES_t TABLES = {
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

		.Gear_5_4 = {68, 70, 71, 72, 72, 75, 80, 85, 95, 98, 106, 114, 120, 120, 120, 120, 122, 122, 122, 124, 124},
		.Gear_4_5 = {75, 77, 78, 80, 80, 85, 90, 100, 105, 110, 120, 130, 140, 140, 140, 140, 142, 142, 142, 144, 144}
	};

#endif
