KoshAlmaron/A650E_Transmission_Controller/sources/gears.h

// Фунции переключения передач.

#ifndef _GEARS_H_
	#define _GEARS_H_

	void set_gear_n();
	void set_gear_1();
	void set_gear_r();
	void disable_gear_r();

	uint8_t get_gear_min_speed(int8_t Gear);
	uint8_t get_gear_max_speed(int8_t Gear);

	void solenoid_init();
	void update_gear_speed();
	void gear_control();
	void slu_gear2_control();

	int8_t get_min_gear(uint8_t Mode);
	int8_t get_max_gear(uint8_t Mode);
	void set_gear_limit(uint8_t Min, uint8_t Max);

#endif
