KoshAlmaron/A650E_Transmission_Controller/(commit log)

2024-05-28 Первая загрузка
    [configuration.h]
2024-06-14 Обновление 14.06.2024
2024-06-18 Добавил документацию
2024-07-02 Добавил управление лампой заднего хода
    [configuration.h]
2024-08-29 Изменил алгоритм расчета и фильтрации значений датчиков оборотов
2024-09-10 Много исправлений после первого теста на АКПП
    [configuration.h]
2024-09-10 Обновление от 2024-09-04
    [configuration.h]
2024-09-10 Переписал алгоритм переключений 1>2, 2>3, 3>2.
    [configuration.h]
2024-09-10 Добавил возможность настраивать и сохранять параметры в EEPROM
    + помощью блока отладки.
    [configuration.h]
2024-09-10 Обновление от 2024-09-05
2024-09-10 Добавил экран настройки температурной коррекции SLU для B3
    [configuration.h]
2024-09-10 Еще раз переделал алгоритм переключения передач
    [configuration.h]
2024-09-10 Сделал плавное включение и выключение блокировки гидротрансформатора
    [configuration.h]
2024-09-10 Обновление от 2024-09-09
2024-09-10 Изменен алгоритма переключения 2>3.
2024-09-10 Исправил температурную коррекцию давления
    [gears.c, tcudata.c, tcudata_tables.h]
2024-09-12 Изменил процесс включения третьей передачи.
    [configuration.h]
2024-09-13 Добавил переключения по оборотам при дросселе более указанного значения
    [configuration.h]
2024-09-16 Исправил включение второй передачи после ХХ
    [configuration.h]
2024-09-17 Мелкие исправления после тестов
    [gears.c, tcudata_tables.h]
2024-09-26 Уменьшил тайминги переключения
    [configuration.h]
2024-09-30 Добавил два графика.
    Добавил график давления SLN и график дельты оборотов для включения
    второй передачи после ХХ.
    [configuration.h]
2024-10-08 Изменил алгоритм управления второй передачей
2024-10-28 Небольшие исправления
2024-10-29 Исправил зависание заднего хода при резком переключении N->R->D
    [debug.c, eeprom.c, gears.c, tcudata.c, tcudata.h, tcudata_tables.h, tculogic.c]
2024-11-26 Улучшил функцию блокировки гидротрансформатора
2024-12-23 Обновление 14.12.2024
    [configuration.h]
2025-01-13 Изменил алгоритм переключения 2>3.
    [configuration.h]
2025-01-13 Применил температурную коррекцию к значению накачки SLU
2025-01-28 Изменил условия срабатывания накачки давления SLU
    [configuration.h]
2025-04-14 Добавил функцию запроса снижения мощности
2025-04-17 Изменил алгоритмы переключений 1>2, 2>3
    [configuration.h]
2025-04-18 Изменил алгоритм переключения 2>3
2025-04-18 Добавил функцию автокоррекции давления SLU включения второй передачи
    [configuration.h]
2025-04-18 Обновил значения графиков.
2025-04-21 Проверка другого алгоритма переключения 2>3
    [configuration.h]
2025-04-22 Добавил автокоррекции давления SLU и включение первой передачи через четвертую (N>D)
    [configuration.h]
2025-04-23 Изменил алгоритм реакцивации второй передачи
    [configuration.h]
2025-05-05 Обновление 2025-05-05
    [configuration.h]
2025-05-14 Изменил алгоритм переключения 2>3 и работы блокировки ГТ
2025-05-16 Навёл порядок в коде блока отладки
2025-05-21 Перешёл на 10-ти битный ШИМ для соленоидов
    [configuration.h]
2025-05-21 Исправил работу второй передачи в режимах "3" и "2"
    [gears.c, tcudata.c]
2025-05-29 Изменил работу блокировки ГТ при переключении передач
2025-05-29 Обновление описания
2025-06-23 Добавил коррекцию по температуре включения SLN при переключении 2>3
    [configuration.h]
2025-07-09 Обновление 2025-07-09
    [configuration.h]
2025-07-21 Увеличил точность вычисления температурной коррекции
2025-07-22 Исправил свежедобавленный баг в функции интерполяции
    [debug.c, gears.c, mathemat.c, tcudata.c]
2025-07-28 Мелкие исправления в работе второй передачи
    [gears.c]
2025-07-29 Добавил возможность выбора пинов селектора
2025-07-30 Обновление 30.07.2025
2025-08-06 Добавил возможность инверсии ШИМ соленоидов в настройках.
    [configuration.h]
2025-08-07 Добавил возможность инверсии входов в настройках
    [configuration.h]
2025-08-07 Вернул назад выход на спидометр
    [configuration.h]
2025-09-05 Добавил протокол обмена по UART
2025-09-08 Добавил опцию определения работы двигателя по сигналу тахометра
    [configuration.h]
2025-09-08 Небольшие исправления в протоколе обмена и в алгоритме второй передачи
    [debug.c, eeprom.c, gears.c, tacho.c, tcudata.c, uart.c]
2025-09-11 Добавил в протокол обмена команду чтения из EEPROM
2025-09-11 Добавил второй порог определения работы двигателя по сигналу тахометра
    [configuration.h]
2025-09-12 Добавил второй выход на спидометр и команду тестирования спидометра
    [configuration.h]
2025-09-12 Добавил в протокол обмена команду установки ограничения передач
    [configuration.h]
2025-09-16 Добавил команду сброса таблиц
2025-09-16 Добавил в пакет данных обороты двигателя
2025-09-18 Добавил задержку сброса флага работы двигателя
2025-10-01 Исправил ошибку применения адаптации
    [configuration.h]
2025-10-07 Добавил команды применения адаптации второй передачи
    [configuration.h]
2025-10-09 Добавил адаптацию времени удержания SLU G3
    [configuration.h]
2025-10-09 Изменил обороты определения закусывания третьей передачи
2025-10-09 Добавил команды применения адаптации G3
2025-10-13 Изменил алгоритм включения второй передачи
2025-10-27 Изменил алгоритм включения режимов RND
    [configuration.h]
2025-10-31 Перенес графики АЦП в EEPROM
2025-11-05 Изменил диапазон таблиц с процентами
    [configuration.h]
2025-11-11 Исправил ошибку в работе алгоритма адаптации
    [configuration.h]
2025-11-27 Большое обновление от 27.11.2025
    [configuration.h]
2025-12-01 Исправил ошибки предыдущего обновления
    [configuration.c, tcudata.c, tcudata.h, tcudata_tables.h]
2025-12-08 Добавил таблицу температурной коррекции для SLN
    [configuration.h]
2025-12-09 Перенес все таблицы в структуры
2025-12-09 Добавил флаги срабатывания адаптаций в основной пакет
    [configuration.h]
2025-12-15 Добавил контрольную сумму в протоколе обмена
2025-12-16 Добавил автоматическое переключение между UART0 и UART1
2025-12-30 Добавил ручное управление АКПП (Типтроник)
    [configuration.h]
2025-12-30 Забыл одну строчку добавить
2025-12-31 Исправление от 31.12.2025
2026-01-09 Добавил барокоррецию. Исправил ошибки в работе типтроника
    [configuration.h]
2026-01-20 Добавил новые функции кнопок ручного управления АКПП (Типтроник)
2026-02-11 2026-02-11.0
    Убрал проверку оборотов для переключения при смене режима АКПП
    селектором.
    Добавил команду отправки версии прошивки.
2026-02-12 2026-02-12.0
    Добавил одометер.
    Изменил формулу расчета скорости.
2026-03-20 2026-03-20.0
    Исправил алгоритм ручного управления АКПП
    [_main.c, buttons.c, gears.c]
2026-03-27 2026-03-27.0
    2026-03-27 - Добавил в настройках коэффициент перевода оборотов в метры.
    [configuration.h]
2026-04-27 2026-04-27.0
    Отключил адаптацию 1>2 в режиме 2.
    Добавил условие выхода из переключения 2>2 по кикдауну.
    Добавил паузу при понижении передачи для стабилизации давления SLN.
2026-05-19 2026-05-19.0
    Добавил возможность отключения автоматического выхода из ручного режима.
2026-06-05 2026-06-05.0
    При включенной передаче минимальная скорость для вывода на спидометер
    будет всегда больше 0 (2).
    [configuration.h]
2026-06-19 2026-06-19.0
    Добавил отдельную таблицу давления SLN для пятой передачи.
    [configuration.h]
